dangrie158/SmartDummyLoad/(list of files, cad)

Other CAD files:
Case/Top.dwg
Case/Front.dwg
Case/Back.dwg
