dangrie158/SmartDummyLoad/Board/PDFs/Schematic.pdf

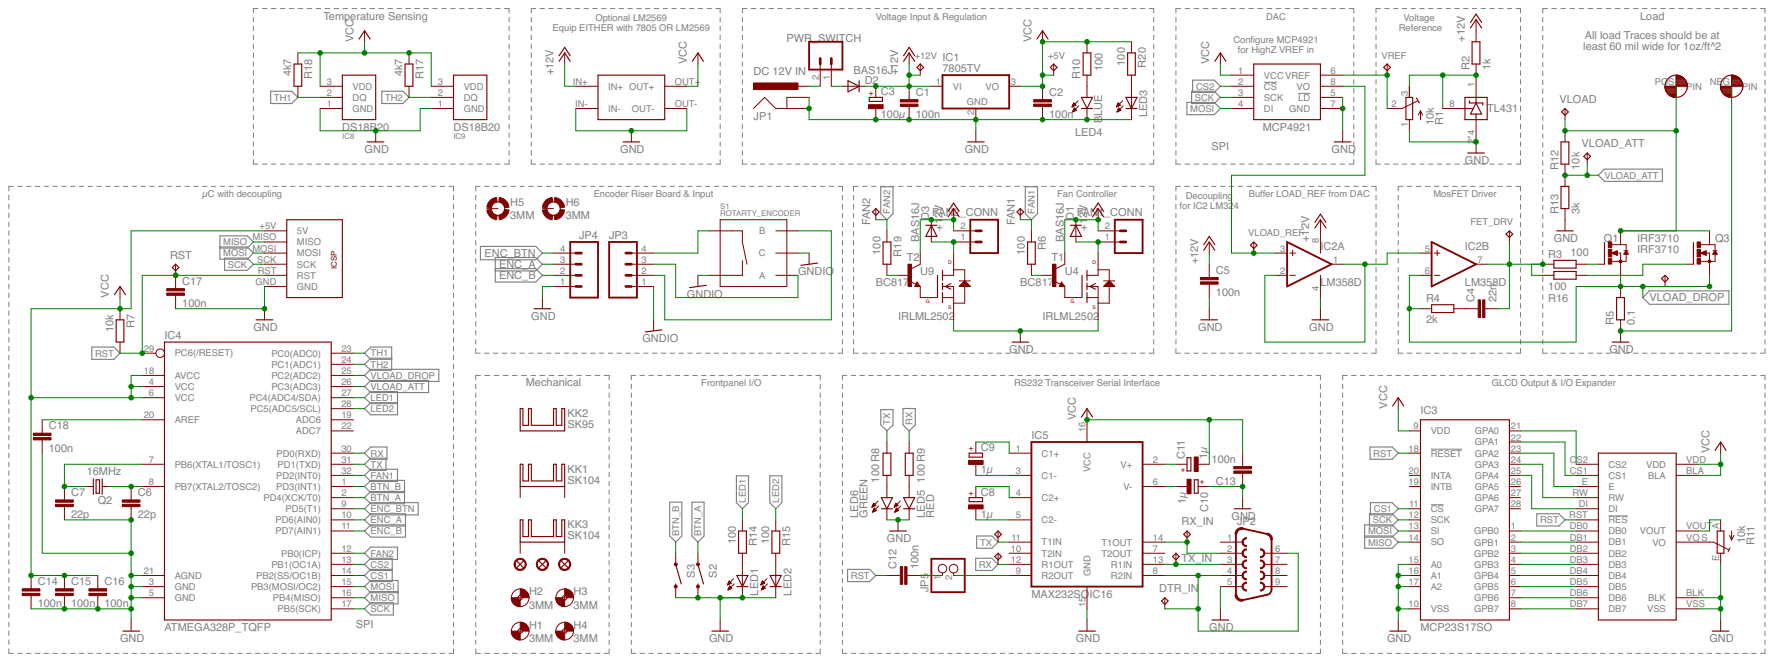
[picture p1: page 1]

Optional LM2569 Equip EITHER with 7805 OR LM2569 Temperature Sensing

All load Traces should be at
least 60 mil wide for 1oz/ft^2

Configure MCP4921
for HighZ VREF in

Encoder Riser Board & Input

6 | VLOAD_ATT LED1
