dangrie158/SmartDummyLoad/Board/PDFs/BoardBlackBottom.pdf

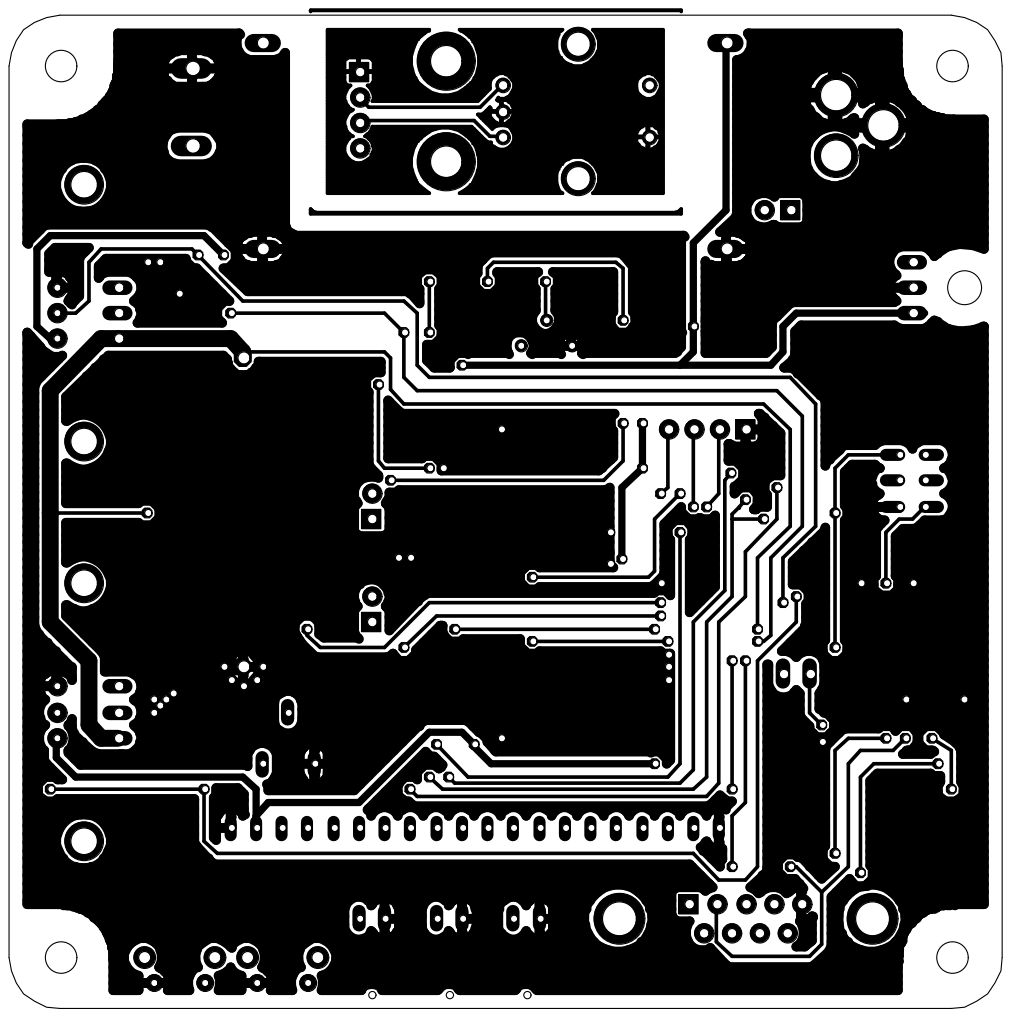
[picture p2: page 1]
