dangrie158/SmartDummyLoad/Board/PDFs/BoardBlackTop.pdf

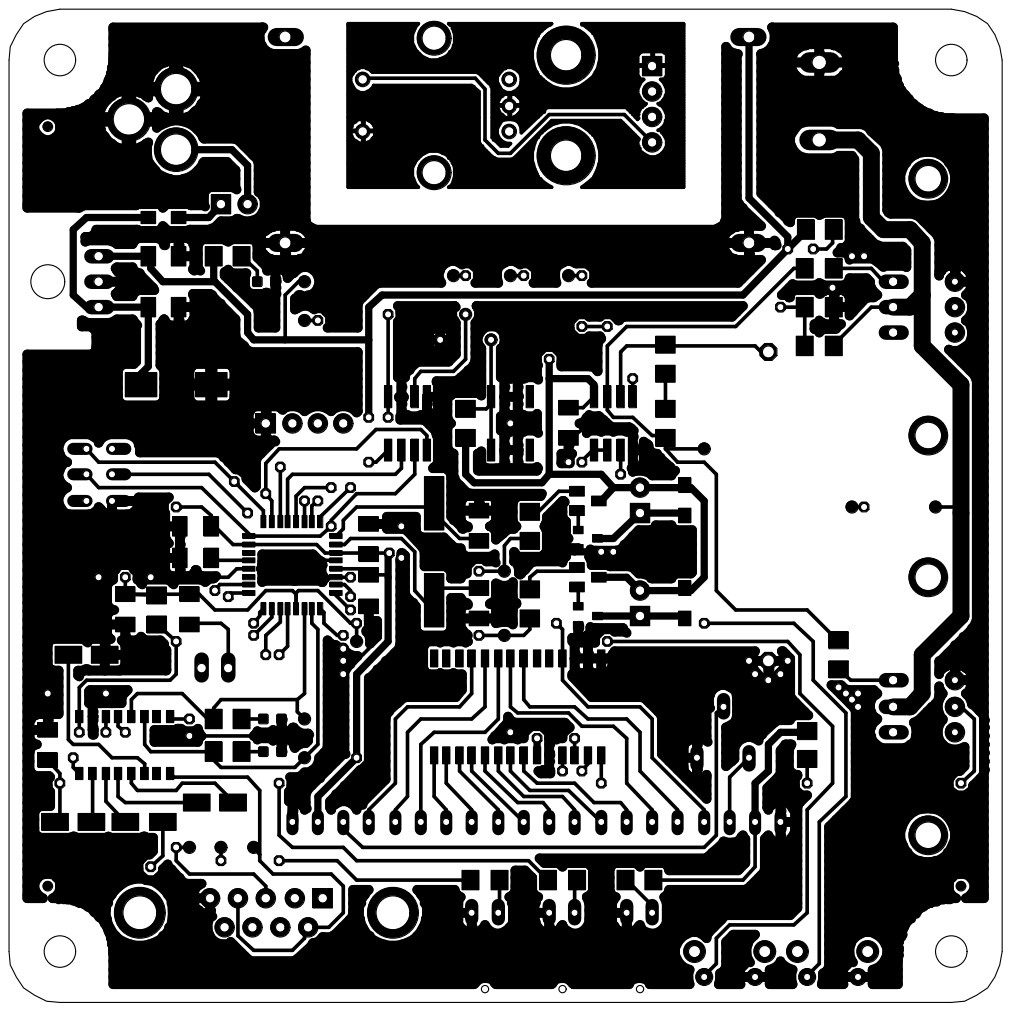
[picture p3: page 1]
