dangrie158/SmartDummyLoad/Board/PDFs/BoardColor.pdf

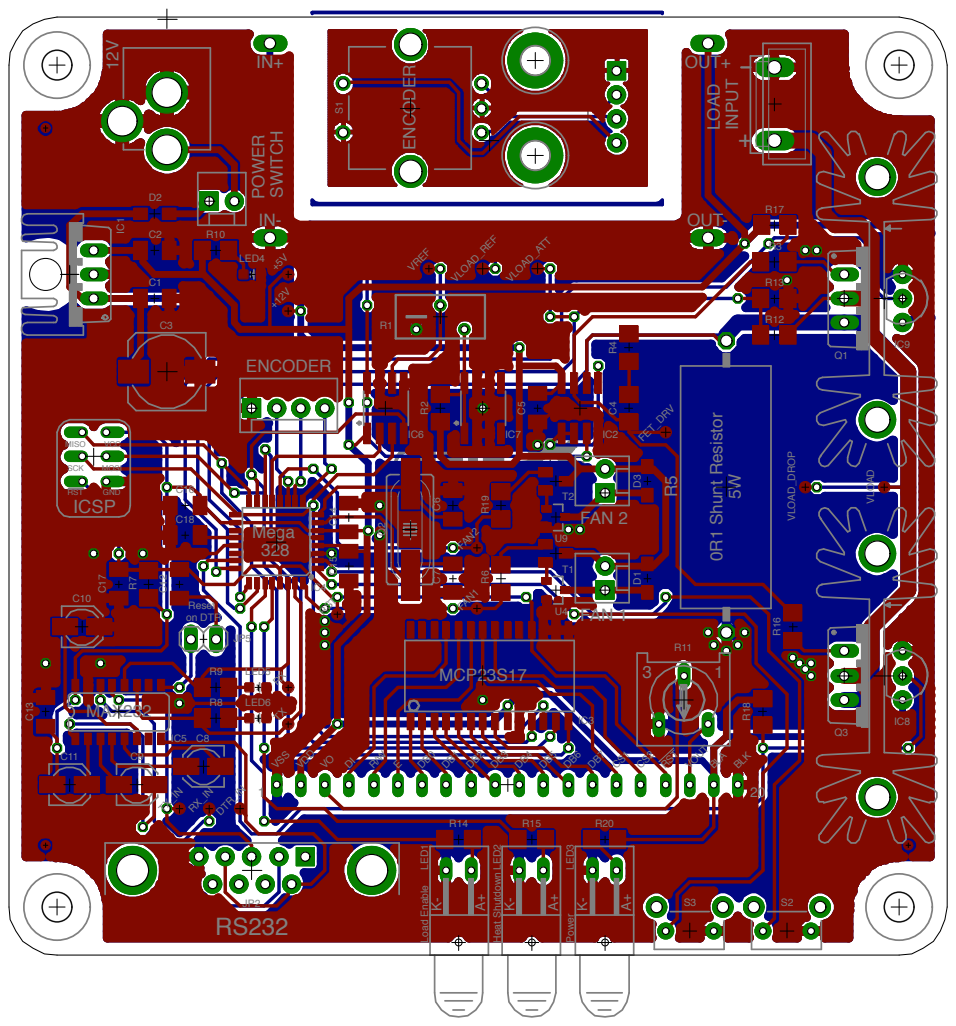
[picture p4: page 1]
