dangrie158/SmartDummyLoad/Board/Board.brd

## EAGLE design Board/Board.brd (2018-09-24)

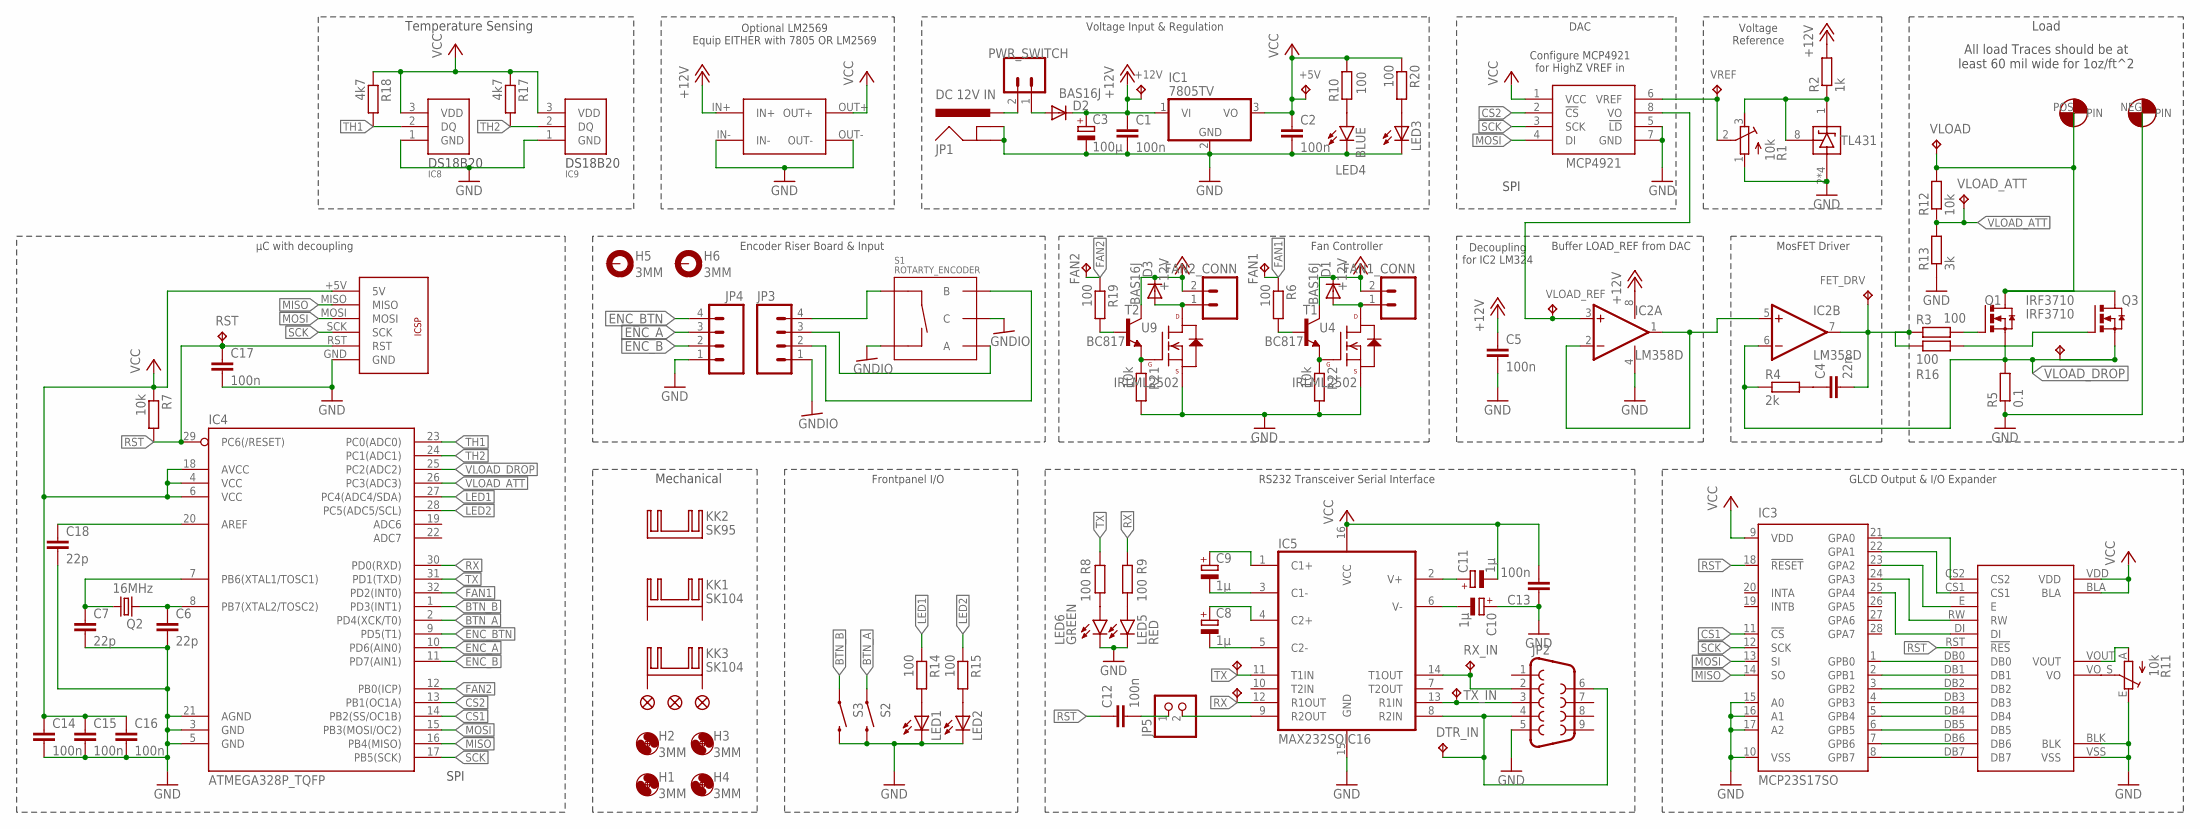
[picture p5: schematic Board.sch]

Parts:
+5V, +12V: TPB1,27; B1,27
C1, C2, C5, C12, C13, C14, C15, C16, C17: 100n; C1206K
C3: 100µ; 175TMP-0808
C4: 22n; C1206
C6, C7, C18: 22p; C1206K
C8, C9, C10, C11: 1µ; 153CLV-0405
D1, D2, D3: BAS16J; SOD323-W
DTR_IN: TPB1,27; B1,27
FAN1, FAN2: TPB1,27; B1,27
FAN1_CONN, FAN2_CONN: M02POLAR; MOLEX-1X2
FET_DRV: TPB1,27; B1,27
FID1, FID2, FID3: FIDUCIAL1X2; FIDUCIAL-1X2
H1, H2, H3, H4: 3MM; 3,0
H5, H6: 3MM; 3,0-PAD
IC1: 7805TV; TO220V
IC2: LM358D; SO08
IC3: MCP23S17SO; SO28W
IC4: ATMEGA328P_TQFP; TQFP32-08
IC5: MAX232SOIC16; SO016
IC6: MCP4921; SO-8
IC7: TL431CD; SO-8
IC8, IC9: DS18B20; TO-92
JP1: DC 12V IN; POWER_JACK_PTH
JP2: DB9FEMALE; DB9
JP3, JP4: M04POLAR; MOLEX-1X4
JP5: PINHD-1X2; 1X02
KK1, KK3: SK104; SK104-PAD
KK2: SK95; SK95-2M3
LED1, LED2, LED3: LEDB155; Q62902-B155
LED4: BLUE; LED-0603
LED5: RED; LED-0603
LED6: GREEN; LED-0603
PWR_SWITCH: M02POLAR; MOLEX-1X2
Q1, Q3: IRF3710; TO-220-V
Q2: 16MHz; HC49UP
R1: 10k; RTRIM3296Y
R2: 1k; M1206
R3, R6, R8, R9, R10, R14, R15, R16, R19, R20: 100; R1206
R4: 2k; R1206
R5: 0.1; VTA52
R7, R12, R21, R22: 10k; R1206
R11: 10k; RS3
R13: 3k; R1206
R17, R18: 4k7; M1206
RST: TPB1,27; B1,27
RX: TPB1,27; B1,27
RX_IN: TPB1,27; B1,27
S1: ROTARTY_ENCODER; ROTARY_ENC_PLAIN
S2, S3: SWITCH-MOMENTARY-2SIDE_EZ; TACTILE-PTH-SIDEEZ
T1, T2: BC817; SOT23-BEC
TX: TPB1,27; B1,27
TX_IN: TPB1,27; B1,27
U4, U9: IRLML2502; SOT23-3
U$3: CON-2-HIGAMP; CON-HIGHAMP-0.3"
U$5: ICSPTHROUGHHOLE; ICSP-THROUGHHOLE
U$6: KS0108-GLCDS6B0108; KS0108-S6B0108-GLCD
U$10: LM2569NO_OUTLINE; LM2596_NO_OUTLINE
VLOAD: TPB1,27; B1,27
VLOAD_ATT: TPB1,27; B1,27
VLOAD_DROP: TPB1,27; B1,27
VLOAD_REF: TPB1,27; B1,27
VREF: TPB1,27; B1,27

Connections:
+12V: +12V.TP, C1.1, C3.+, C5.1, D1.C, D2.C, D3.C, FAN1_CONN.2, FAN2_CONN.2, IC1.1 (VI), IC2.8 (V+), R2.2, T1.C, T2.C, U$10.IN+
BTN_A: IC4.2 (PD4(XCK/T0)), S2.1
BTN_B: IC4.1 (PD3(INT1)), S3.1
CS1: IC3.11 (!CS), IC4.14 (PB2(SS/OC1B))
CS2: IC4.13 (PB1(OC1A)), IC6.2 (!CS!)
ENC_A: IC4.10 (PD6(AIN0)), JP4.3
ENC_B: IC4.11 (PD7(AIN1)), JP4.2
ENC_BTN: IC4.9 (PD5(T1)), JP4.4
FAN1: FAN1.TP, IC4.32 (PD2(INT0)), R6.1
FAN2: FAN2.TP, IC4.12 (PB0(ICP)), R19.1
GND: C1.2, C2.2, C3.-, C5.2, C6.2, C7.2, C10.+, C13.1, C14.2, C15.2, C16.2, C17.2, C18.2, IC1.2 (GND), IC2.4 (V-), IC3.10 (VSS), IC3.15 (A0), IC3.16 (A1), IC3.17 (A2), IC4.3 (GND), IC4.5 (GND), IC4.21 (AGND), IC5.15 (GND), IC6.5 (!LD!), IC6.7 (GND), IC7.2 (ANODE), IC7.3 (ANODE), IC7.6 (ANODE), IC7.7 (ANODE), IC8.1 (GND), IC9.1 (GND), JP1.GND, JP1.GNDBREAK, JP2.5, JP4.1, LED1.K (C), LED2.K (C), LED3.K (C), LED4.C, LED5.C, LED6.C, R1.1 (A), R5.1, R11.E, R13.1, R21.2, R22.2, S2.2, S3.2, U4.2 (S), U9.2 (S), U$3.NEG, U$5.GND, U$6.BLK, U$6.VSS, U$10.IN-, U$10.OUT-
GNDIO: JP3.1, S1.C, S1.SW-
LED1: IC4.27 (PC4(ADC4/SDA)), R14.1
LED2: IC4.28 (PC5(ADC5/SCL)), R15.1
LOAD+: Q1.2 (D), Q3.2 (D), R12.2, U$3.POS, VLOAD.TP
MISO: IC3.14 (SO), IC4.16 (PB4(MISO)), U$5.MISO
MOSI: IC3.13 (SI), IC4.15 (PB3(MOSI/OC2)), IC6.4 (DI), U$5.MOSI
unnamed: IC7.1 (CATHODE), IC7.8 (REF), R1.3 (E), R2.1
unnamed: IC6.6 (VREF), R1.2 (S), VREF.TP
unnamed: C4.1, R4.2
unnamed: R22.1, T1.E, U4.1 (G)
unnamed: D1.A, FAN1_CONN.1, U4.3 (D)
unnamed: Q1.1 (G), R3.2
unnamed: IC5.9 (R2OUT), JP5.2
unnamed: R6.2, T1.B
unnamed: C7.1, IC4.7 (PB6(XTAL1/TOSC1)), Q2.1
unnamed: C4.2, FET_DRV.TP, IC2.7 (OUT), R3.1, R16.1
unnamed: C6.1, IC4.8 (PB7(XTAL2/TOSC2)), Q2.2
unnamed: DTR_IN.TP, IC5.8 (R2IN), JP2.4, JP2.6
unnamed: IC5.14 (T1OUT), JP2.2, RX_IN.TP
unnamed: IC5.13 (R1IN), JP2.3, TX_IN.TP
unnamed: C9.-, IC5.3 (C1-)
unnamed: C9.+, IC5.1 (C1+)
unnamed: C8.-, IC5.5 (C2-)
unnamed: C8.+, IC5.4 (C2+)
unnamed: C11.+, IC5.2 (V+)
unnamed: LED4.A, R10.2
unnamed: C10.-, IC5.6 (V-)
unnamed: LED6.A, R8.2
unnamed: LED5.A, R9.2
unnamed: R11.S, U$6.VO
unnamed: R11.A, U$6.VOUT
unnamed: JP1.PWR, PWR_SWITCH.2
unnamed: IC3.1 (GPB0), U$6.DB0
unnamed: IC3.2 (GPB1), U$6.DB1
unnamed: IC3.3 (GPB2), U$6.DB2
unnamed: IC3.4 (GPB3), U$6.DB3
unnamed: IC3.5 (GPB4), U$6.DB4
unnamed: IC3.6 (GPB5), U$6.DB5
unnamed: IC3.7 (GPB6), U$6.DB6
unnamed: IC3.8 (GPB7), U$6.DB7
unnamed: IC3.21 (GPA0), U$6.CS2
unnamed: IC3.22 (GPA1), U$6.CS1
unnamed: IC3.23 (GPA2), U$6.E
unnamed: IC3.24 (GPA3), U$6.RW
unnamed: IC3.25 (GPA4), U$6.DI
unnamed: C18.1, IC4.20 (AREF)
unnamed: D2.A, PWR_SWITCH.1
unnamed: R21.1, T2.E, U9.1 (G)
unnamed: LED1.A, R14.2
unnamed: LED2.A, R15.2
unnamed: JP3.4, S1.SW+
unnamed: JP3.3, S1.A
unnamed: Q3.1 (G), R16.2
unnamed: R19.2, T2.B
unnamed: JP3.2, S1.B
unnamed: D3.A, FAN2_CONN.1, U9.3 (D)
unnamed: LED3.A, R20.2
RST: C12.1, C17.1, IC3.18 (!RESET), IC4.29 (PC6(/RESET)), R7.2, RST.TP, U$5.RST, U$6.RST (!RES!)
RST_EN: C12.2, JP5.1
RX: IC4.30 (PD0(RXD)), IC5.12 (R1OUT), R9.1, RX.TP
SCK: IC3.12 (SCK), IC4.17 (PB5(SCK)), IC6.3 (SCK), U$5.SCK
TH1: IC4.23 (PC0(ADC0)), IC8.2 (DQ), R18.2
TH2: IC4.24 (PC1(ADC1)), IC9.2 (DQ), R17.2
TX: IC4.31 (PD1(TXD)), IC5.11 (T1IN), R8.1, TX.TP
VCC: +5V.TP, C2.1, C11.-, C13.2, C14.1, C15.1, C16.1, IC1.3 (VO), IC3.9 (VDD), IC4.4 (VCC), IC4.6 (VCC), IC4.18 (AVCC), IC5.16 (VCC), IC6.1 (VCC), IC8.3 (VDD), IC9.3 (VDD), R7.1, R10.1, R17.1, R18.1, R20.1, U$5.+5V (5V), U$6.BLA, U$6.VDD, U$10.OUT+
VLOAD_ATT: IC4.26 (PC3(ADC3)), R12.1, R13.2, VLOAD_ATT.TP
VLOAD_DROP: IC2.6 (-IN), IC4.25 (PC2(ADC2)), Q1.3 (S), Q3.3 (S), R4.1, R5.2, VLOAD_DROP.TP
VLOAD_REF: IC2.3 (+IN), IC6.8 (VO), VLOAD_REF.TP
VREF_BUF: IC2.1 (OUT), IC2.2 (-IN), IC2.5 (+IN)

Notes on the sheet:
Buffer LOAD_REF from DAC
Decoupling for IC2 LM324
MosFET Driver
Load
Voltage Reference
DAC
Voltage Input & Regulation
Mechanical
Fan Controller
All load Traces should be at least 60 mil wide for 1oz/ft^2
SPI
Configure MCP4921 for HighZ VREF in
Encoder Riser Board & Input
GLCD Output & I/O Expander
RS232 Transceiver Serial Interface
Optional LM2569 Equip EITHER with 7805 OR LM2569
Temperature Sensing
Frontpanel I/O
µC with decoupling

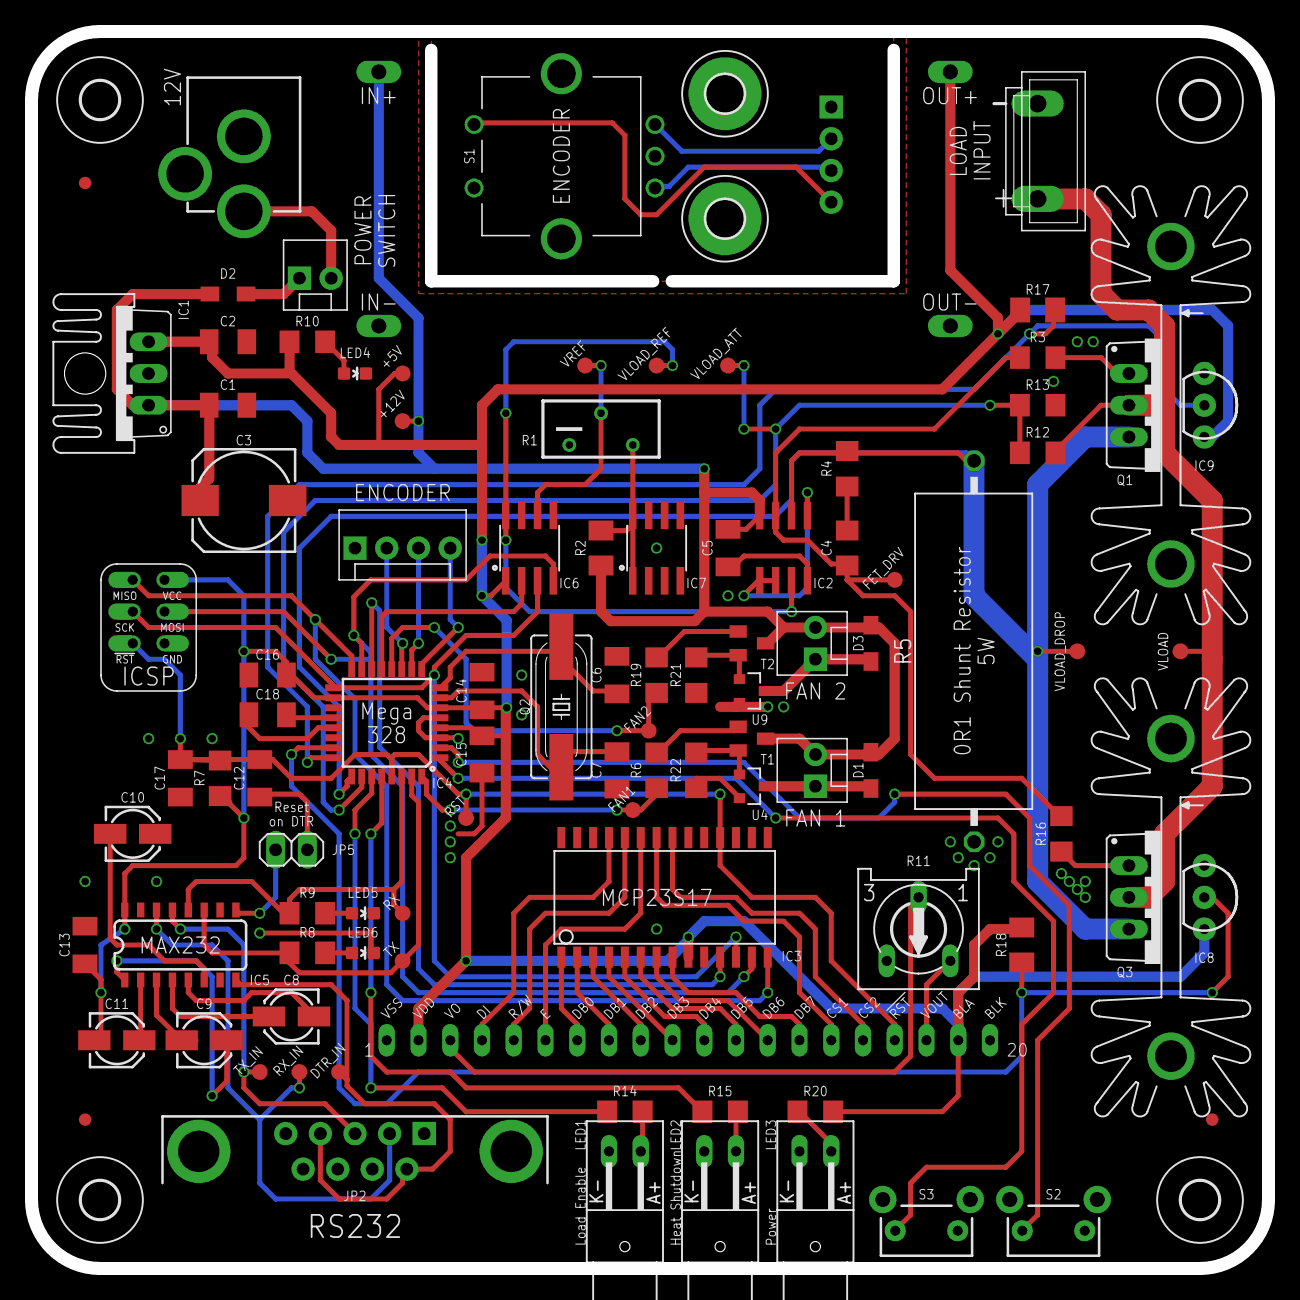
[picture p6: board Board.brd from above]

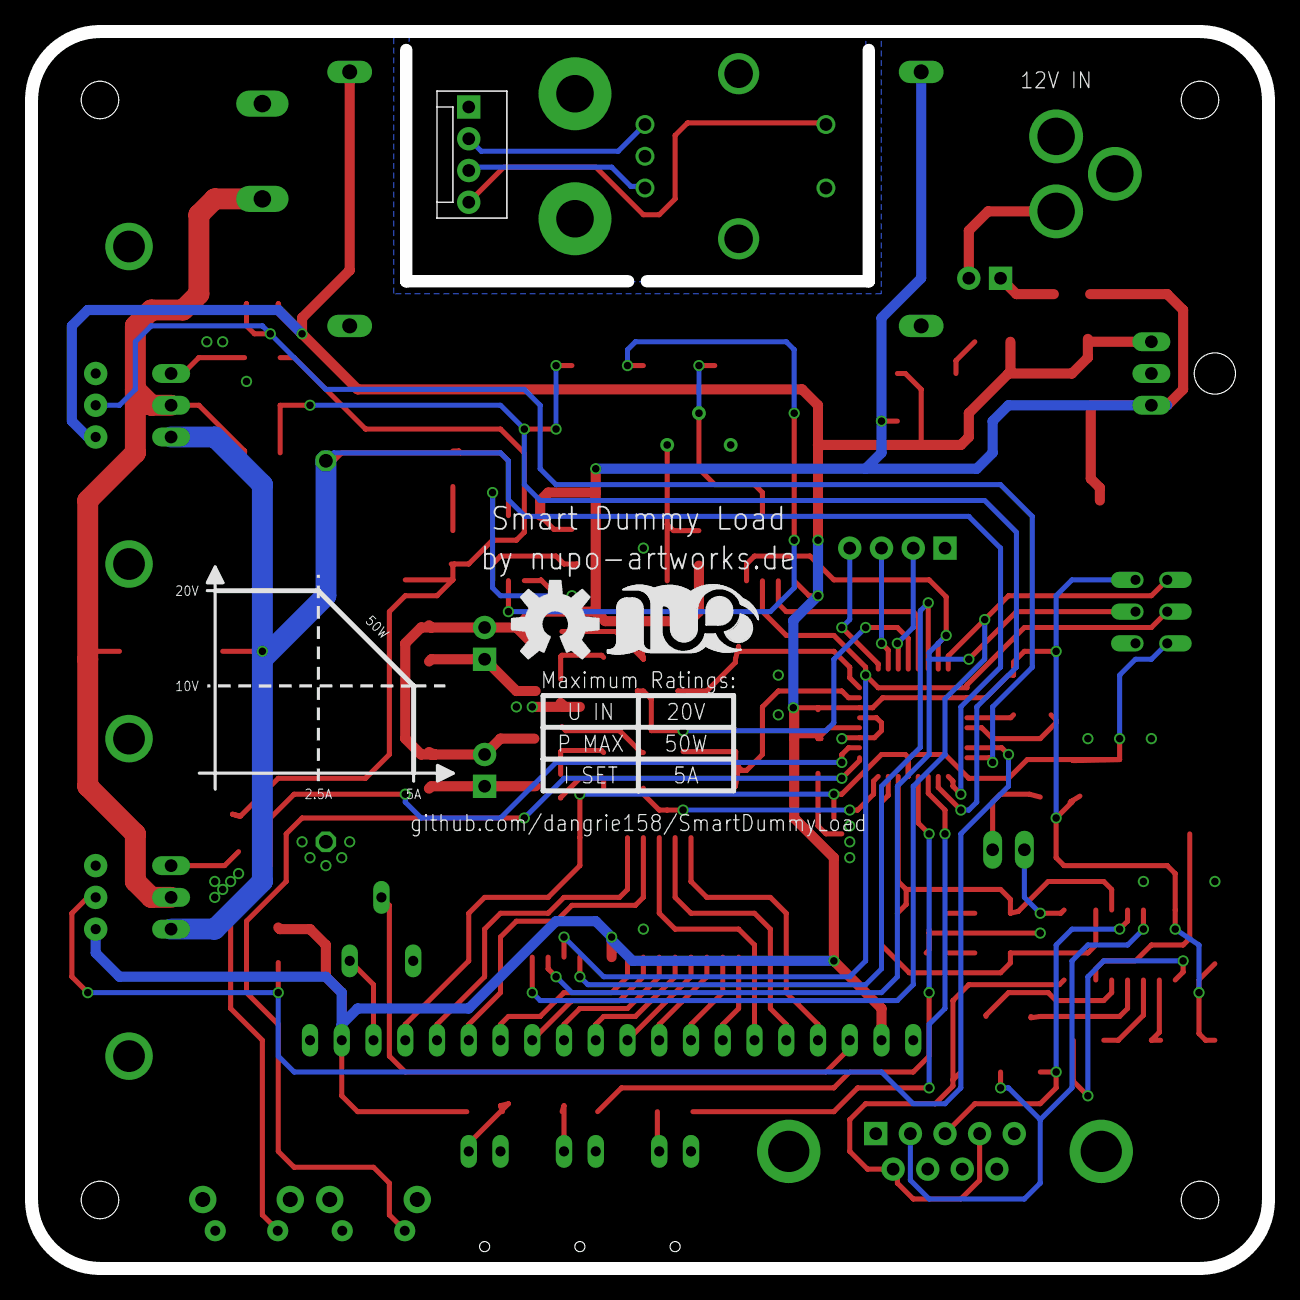
[picture p7: board Board.brd from below]

Board: 2 copper layers, 99.0 x 99.0 mm, 110 parts (3 on the bottom side), 80 nets.

Other parts of the board:
U$1: LOGO-SILKSCREEN
U$2: OSHW-LOGO-L
