dangrie158/SmartDummyLoad/Firmware/src/pins.h

// The chip select pin for the MCP4921 DAC
#define CS_DAC 9

// the chip select pin for the MCP23S17 GPIO expander
#define CS_GPIO 10

#define FAN1 2
#define FAN2 8

#define TEMP_SENS1 A0
#define TEMP_SENS2 A1

#define LED1 A4
#define LED2 A5

#define BUTTON_A 4
#define BUTTON_B 3
#define ENC_A 6
#define ENC_B 7
#define ENC_BTN 5

#define VLOAD A3
#define ILOAD A2
