dangrie158/SmartDummyLoad/(commit log)

2016-03-09 Initial Commit
    This Initial Commit adds the Basic Schematic in the first Version
    [LoadBoard.brd, LoadBoard.sch]
2016-03-12 Added second MosFET Stage and Temperature Sensing
    [LoadBoard.sch]
2016-03-12 routed first version of the board
    [LoadBoard.brd]
2016-03-12 added second fan controller
    [LoadBoard.sch]
2016-03-12 Routed more of the Board, added an optional LM2569 Module
    [LoadBoard.brd]
2016-03-13 worked on silkscreen for passives
    [LoadBoard.brd, LoadBoard.sch]
2016-03-13 added silkscreen information to bottom
    [LoadBoard.brd, LoadBoard.sch]
2016-03-13 added fiducials to the board
    [LoadBoard.brd, LoadBoard.sch]
2016-03-20 added documentation to bottom of board
    [LoadBoard.brd]
2016-03-20 refactored project structure
    [LoadBoard.brd, LoadBoard.sch]
2016-03-20 renamed Board Files in preparation for Exporting PDFs
    [Board.brd, Board.sch]
2016-03-20 added PDFs for the Board and Schematic
2016-04-16 added pull downs to fan drver gates
    [Board.brd, Board.sch]
2016-04-17 lowered decoupling capacitance for VREF to allow fast switching of references
    [Board.brd, Board.sch]
2016-04-24 switched to platform.io
2016-04-26 removed custom lib ClickEncoder and switched to platfomio provided one
2016-04-29 added sample native mapping for GLCD Lib
2016-06-07 split out source path of the driving MosFETs
    [Board.brd]
2016-06-15 fixed wrong chipset orientation with new LCD
    [MCP23S17GLCDMapping.h]
2016-06-15 added functions to asynchronously request the temperature from DS18B20 sensors
2016-06-15 added clamping to Progressbar MAX_VALUE instead of ignoring the set
2016-06-15 added enclosure design files
    [Back.dwg, Front.dwg, Top.dwg]
2018-09-24 updated firmware
    [Back.dwg, Board.brd, Board.sch, Front.dwg, Top.dwg]
